JakubK/open-source-leader-arm/pcb/tht/arm.kicad_pcb

## KiCad design pcb/tht/arm.kicad_pcb (2026-10-10)

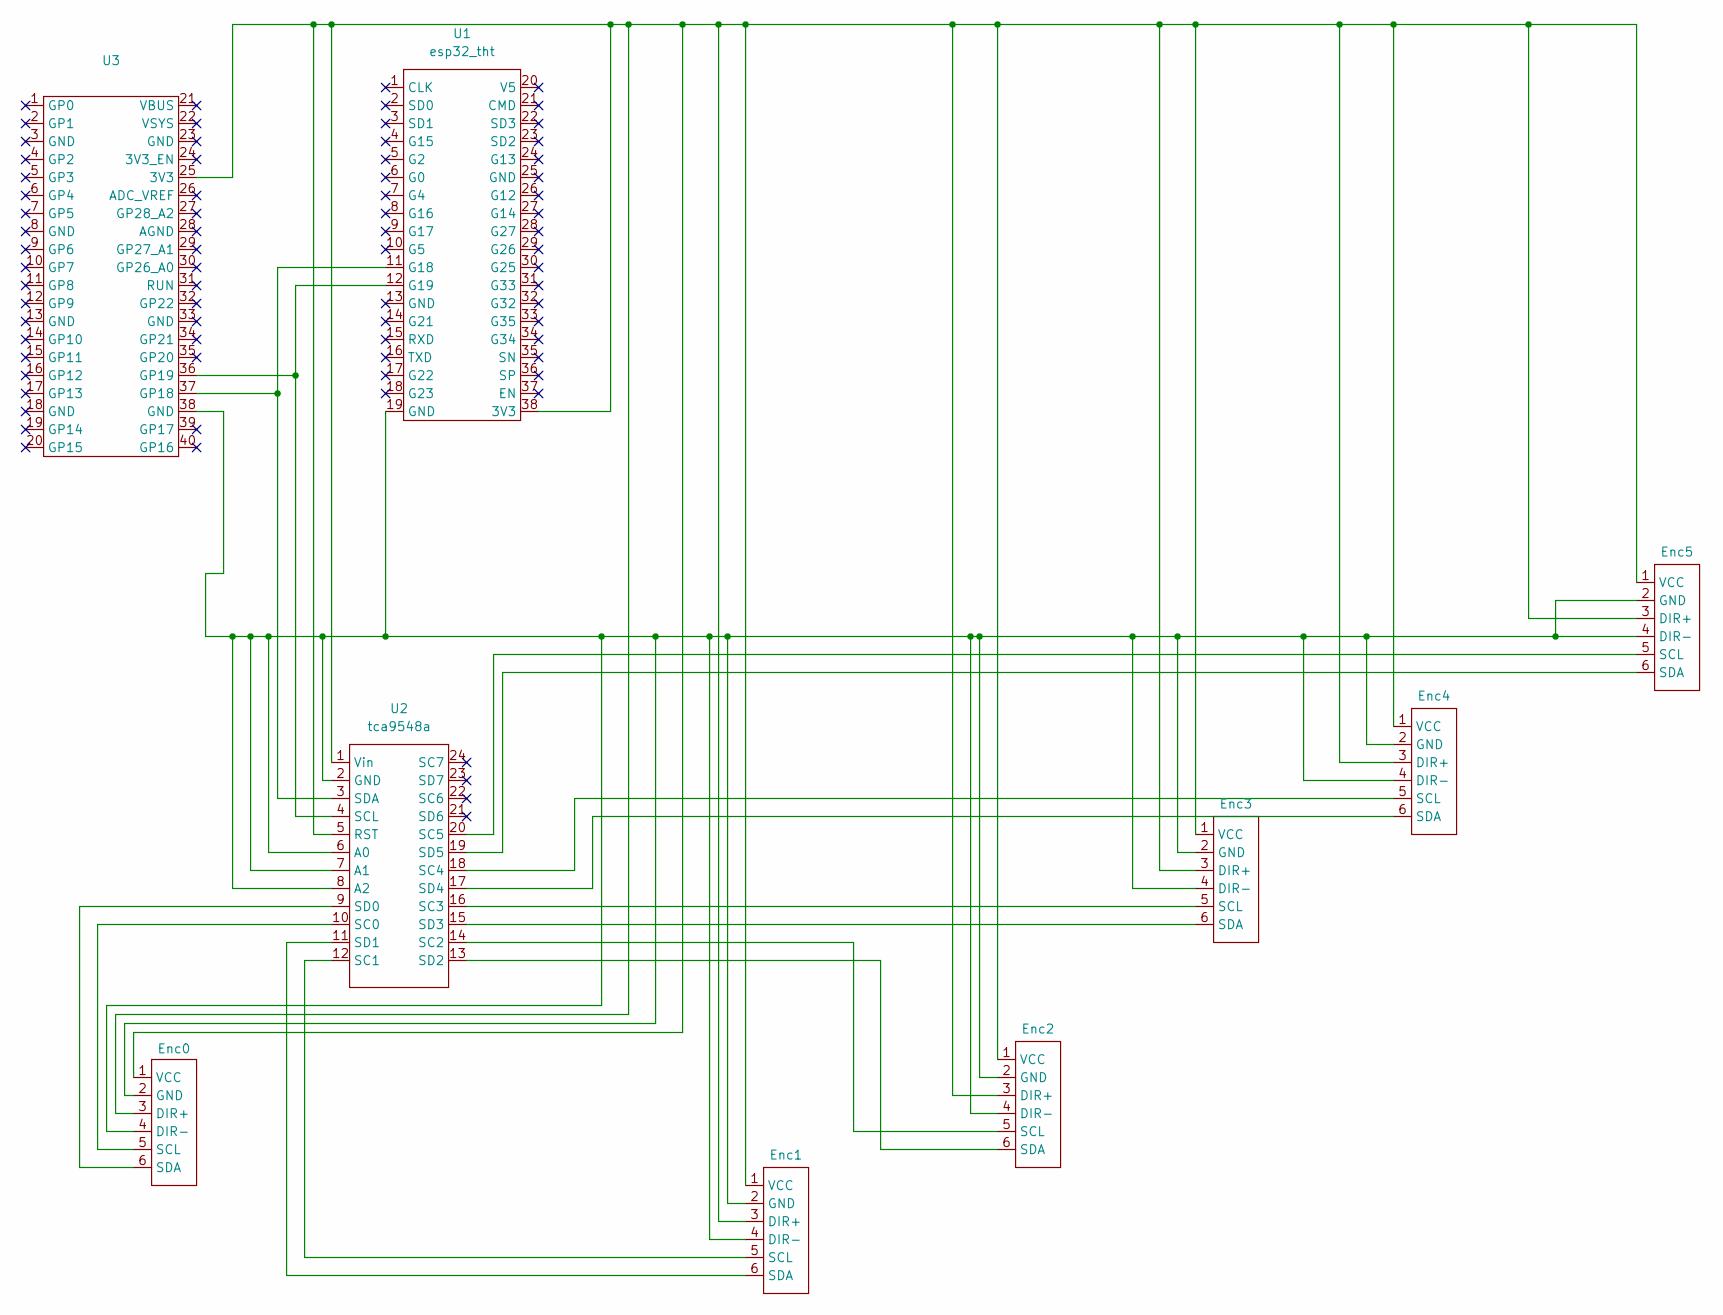
[picture p1: schematic arm.kicad_sch]

Parts:
Enc0, Enc1, Enc2, Enc3, Enc4, Enc5: AS5600_THT
U1: esp32_tht
U2: tca9548a; TCA9548A_THT
U3: pico_tht

Connections:
unnamed: Enc0.1 (VCC), Enc0.3 (DIR+), Enc1.1 (VCC), Enc1.3 (DIR+), Enc2.1 (VCC), Enc2.3 (DIR+), Enc3.1 (VCC), Enc3.3 (DIR+), Enc4.1 (VCC), Enc4.3 (DIR+), Enc5.1 (VCC), Enc5.3 (DIR+), U1.38 (3V3), U2.1 (Vin), U2.5 (RST), U3.25 (3V3)
unnamed: Enc0.2 (GND), Enc0.4 (DIR-), Enc1.2 (GND), Enc1.4 (DIR-), Enc2.2 (GND), Enc2.4 (DIR-), Enc3.2 (GND), Enc3.4 (DIR-), Enc4.2 (GND), Enc4.4 (DIR-), Enc5.2 (GND), Enc5.4 (DIR-), U1.19 (GND), U2.2 (GND), U2.6 (A0), U2.7 (A1), U2.8 (A2), U3.38 (GND)
unnamed: Enc0.5 (SCL), U2.10 (SC0)
unnamed: Enc0.6 (SDA), U2.9 (SD0)
unnamed: Enc1.5 (SCL), U2.12 (SC1)
unnamed: Enc1.6 (SDA), U2.11 (SD1)
unnamed: Enc2.5 (SCL), U2.14 (SC2)
unnamed: Enc2.6 (SDA), U2.13 (SD2)
unnamed: Enc3.5 (SCL), U2.16 (SC3)
unnamed: Enc3.6 (SDA), U2.15 (SD3)
unnamed: Enc4.5 (SCL), U2.18 (SC4)
unnamed: Enc4.6 (SDA), U2.17 (SD4)
unnamed: Enc5.5 (SCL), U2.20 (SC5)
unnamed: Enc5.6 (SDA), U2.19 (SD5)
unnamed: U1.11 (G18), U2.3 (SDA), U3.37 (GP18)
unnamed: U1.12 (G19), U2.4 (SCL), U3.36 (GP19)

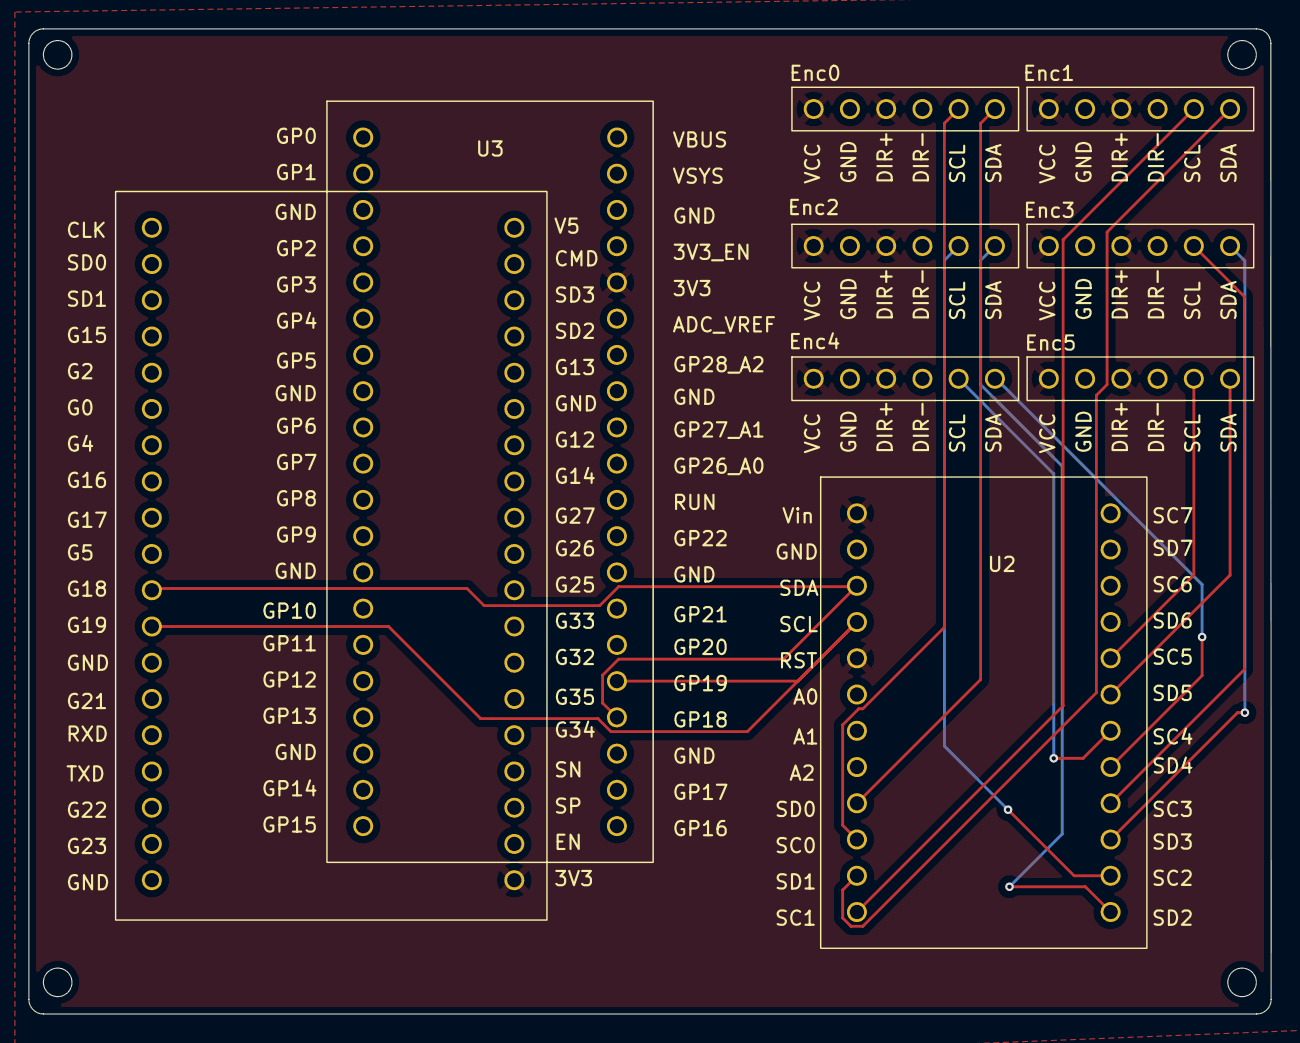
[picture p2: board arm.kicad_pcb from above]

Board: 2 copper layers, 87.1 x 69.0 mm, 9 parts (0 on the bottom side), 16 nets.
