JakubK/open-source-leader-arm/(commit log)

2026-10-10 Add PCB and update README.md
    [arm.kicad_pcb, arm.kicad_sch]
2026-10-10 Changes related to regions
    [arm.kicad_pcb]
